huangms1/POCT/readme.txt

MCU：STM32F429ZGT6

运行平台：臻惠医疗POCT仪器设备。
创建人：黄明送
创建日期：2021、11，16

修改记录：
1.TIM10做为时基定时器，       2021/11/17
2.电机驱动部分                2021/11/18
3.和并通信协议                2021/12/06
4.整合版本                    2022/01/19

5.新增PCA9535PW 扩展IO芯片 ，用于调节电机细分。
\

2022/5/13

1.修改   Motor_fre函数中的表达试。
