huangms1/POCT/接线图-EFD25-5.3.pdf

# 骨架名称：EFD25 卧式 5+5 SMD

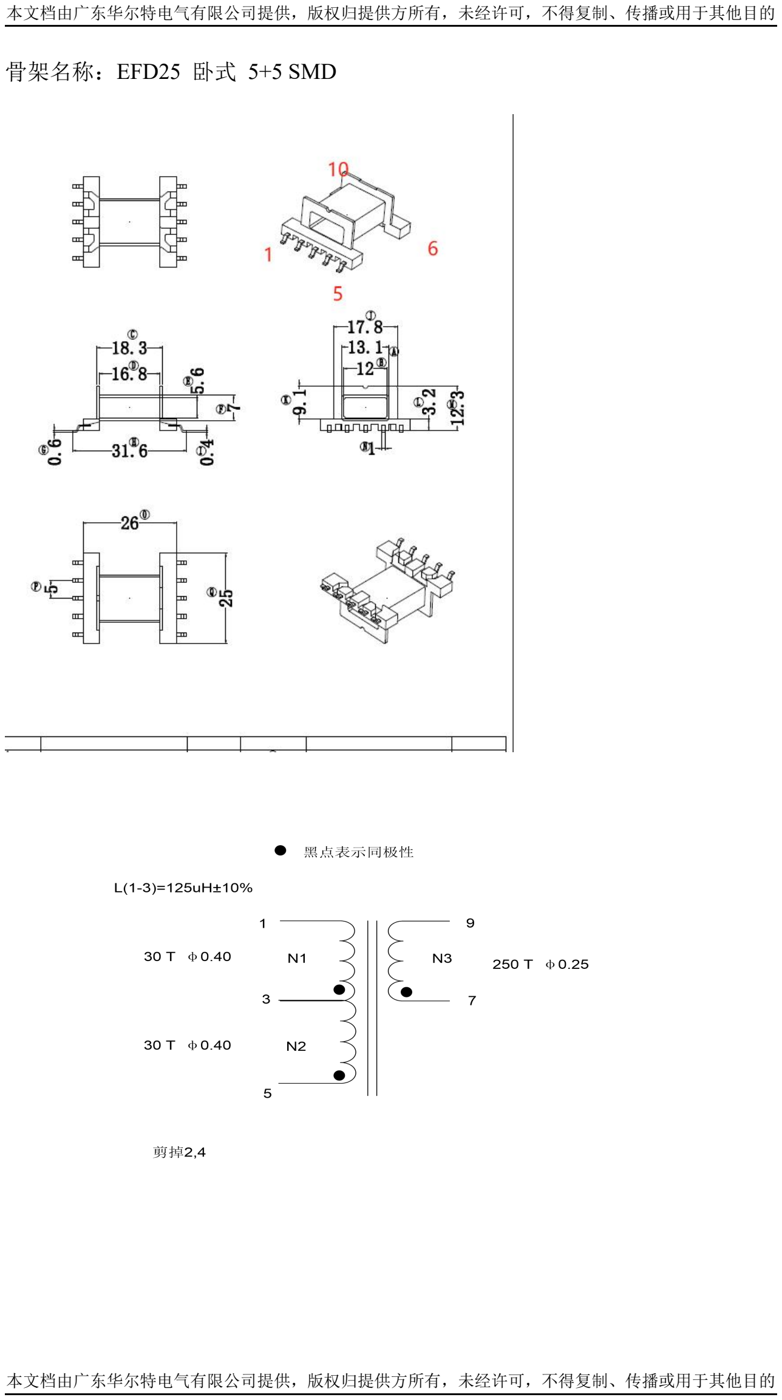
[picture p28: page 1]

本文档由广东华尔特电气有限公司提供，版权归提供方所有，未经许可，不得复制、传播或用于其他目的

本文档由广东华尔特电气有限公司提供，版权归提供方所有，未经许可，不得复制、传播或用于其他目的
