huangms1/POCT/滨松MPPC电路图.png

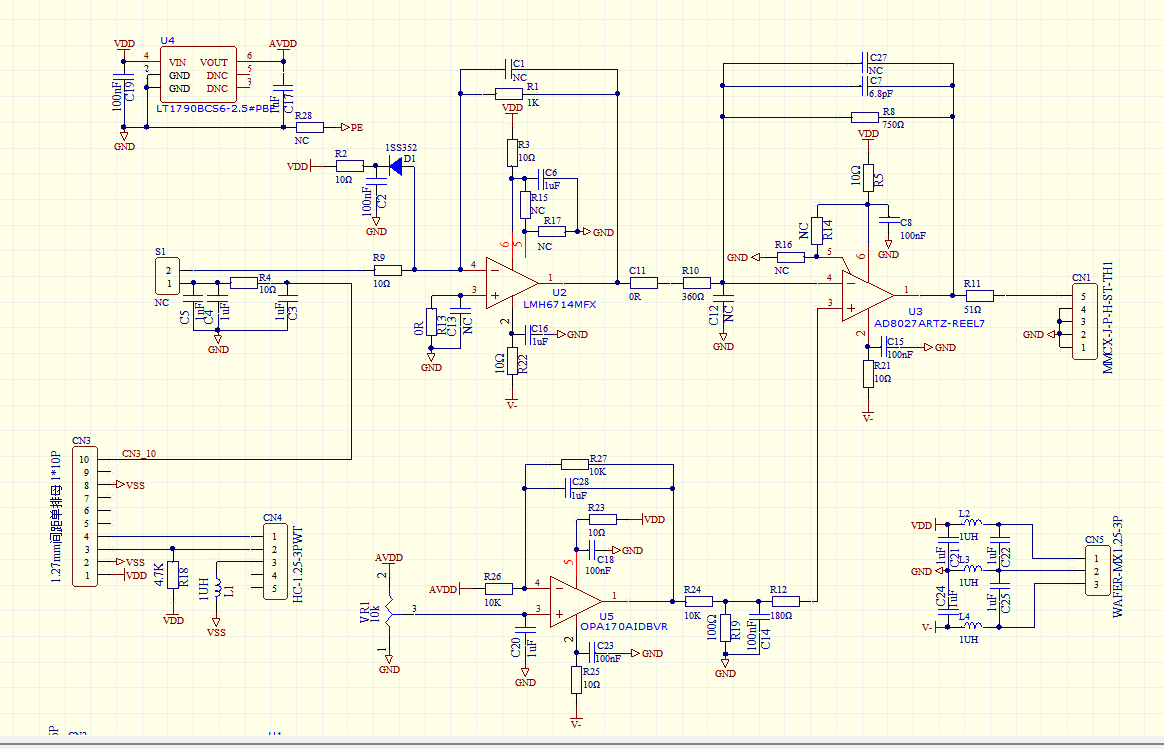
滨松MPPC电路图.png
