huangms1/POCT/耗材.png

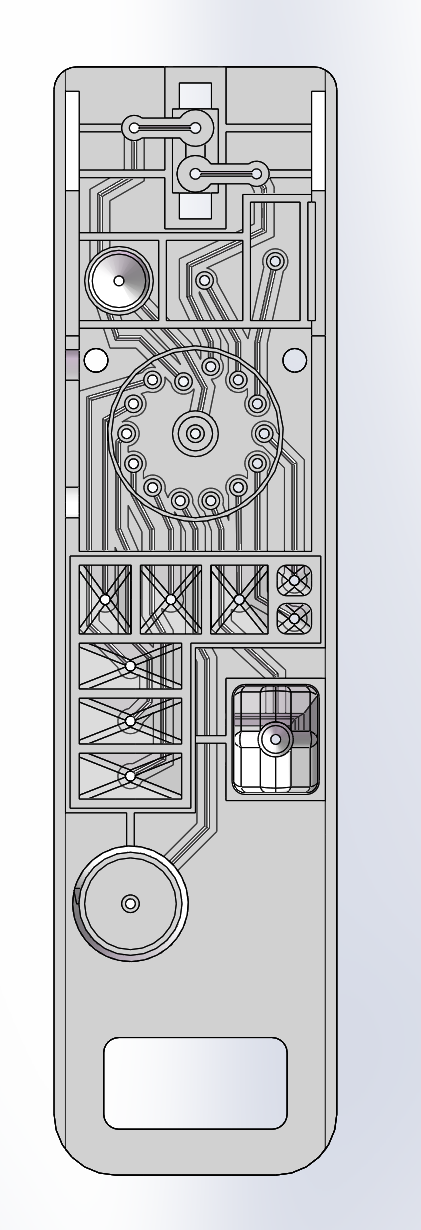
耗材.png
