huangms1/POCT/(list of files, drawings)

Other design files:
基于金诺美加热模块/PCB1_Project/PCB1_Project/CAN.SchDoc
基于金诺美加热模块/PCB1_Project/PCB1_Project/EEPROM.SchDoc
基于金诺美加热模块/PCB1_Project/PCB1_Project/JCXT.PrjPcb
基于金诺美加热模块/PCB1_Project/PCB1_Project/LED.SchDoc
基于金诺美加热模块/PCB1_Project/PCB1_Project/Motor.SchDoc
基于金诺美加热模块/PCB1_Project/PCB1_Project/Power.SchDoc
基于金诺美加热模块/PCB1_Project/PCB1_Project/RS232.SchDoc
基于金诺美加热模块/PCB1_Project/PCB1_Project/STM32F429.SchDoc
基于金诺美加热模块/PCB1_Project/PCB1_Project/Temp.SchDoc
基于金诺美加热模块/PCB1_Project/PCB1_Project/USB.SchDoc
基于金诺美加热模块/PCB1_Project/PCB1_Project/W5500.SchDoc
基于金诺美加热模块/PCB1_Project/PCB1_Project/XG_DW_POCT_2K10LED_3.SCHLIB
基于金诺美加热模块/PCB1_Project/PCB1_Project/XG_DW_POCT_2K10LED_V2.0_2024.11.151.PcbLib
