huangms1/POCT/(commit log)

2025-09-23 提交文件
2025-09-23 更改信息
2025-09-25 首次上传
2025-09-25 上传备份
2025-09-25 新版耗材管路
2025-09-26 首次提交金诺美模块
    [CAN.SchDoc, EEPROM.SchDoc, JCXT.PrjPcb, LED.SchDoc, Motor.SchDoc, Power.SchDoc, RS232.SchDoc, STM32F429.SchDoc]
